D-uality/Robocup-Singapore-Open/Robocup Notebook.docx

Robocup Notebook

Robocup 2023 – Frederick Sun | Yuki Wu

# Design Process

## Composition of Robot

The composition of our robot is extremely important, as it determines how all the components fit together, what software we need to be able to program, and how different things are needed to sustain a closed-loop feedback system for a task as intensive as ours.

### Design Material

When building the robot, the basic material needs to be considered. We are aiming for a material that fits:

- Something strong and not brittle, can handle excessive forces.
- Can be easily modified so many different iterations can be tested.
- How readily available it is to our team, in New Zealand, and the relative cost of it.

The options are:

#### Nylon

Nylon is extremely lightweight and low in density, only just 1.14g/cm^3. This would be advantageous to use in higher quantities as it is extremely light and has no significant impact on the design structure of our robot.

Furthermore, Nylon has a great compressive force resistance, with its Young Modulus, E, at 2.7GPa. This would allow us to hold all the heavy components without issue and 3be able to support varying loads.

However, working with Nylon is hard and dangerous. Using Nylon would usually leave a trace of hard, sharp residue after cutting, which poses serious safety concerns.

#### Fibreglass Boards

Fibreglass is extremely strong with a Young Modulus of up to 87 GPa, significantly more resistant to damages that may occur, such as snapping or cracking when being handled. This is one of the main advantages.

It is relatively inexpensive, and easy to work with. However, the execution of creating small, precise hole cut outs is questionable. Furthermore, it requires the use of a binding material, through resin, which would only further complicate the matter.

Another concern is its density. At roughly 48g/cm^3, this is significantly heavier than that of the other materials, and would create extra strain on the motors, which is unneeded for.

#### PLA – 3D Printing

#### ABS – 3D Printing

### Wheels

The size of the wheels depends on the radius and the thickness. These two factors

### Microcontroller

### Claw Design

### Dump Design

Using linkage, we were able to simulate a 2d version of the entire robot and it's mechanisms

## Line Following

### Closed Loop system

The line following process is a complex one: involving many different techniques. We aim to use a closed-loop information feedback system to accurately control our robot and its position within the course. This will improve its accuracy and reliability.

Given the inputs v, for colour sensor inputs, and t, for time, we can use the PID controller to determine the accurate output as a function of both inputs, o(v, t).

This formula describes how the output given time and the sensor inputs can be determined.

e(v,t) is the error difference between two sides of the colour sensors rack, as an error of 0 would indicate that the colour sensors are reading the same value, therefore the same colour, which is most likely both white.

describes the sum of all errors since the controller has started to run. Gives indication to how long an error has been occurring with respect time, showing how this must be a longer turn. This would only work if the error would go negative, otherwise there would be a systematic error to turn whichever way was described as positive.

describes the rate of change of error, given the smallest change in t, which is the last reading. This would give indication as to how rapidly the error is changing with respect to time, meaning any given turn is sharper, hence needing more power.

To properly implement this into our system, we would need to use modified values, as the raw values are much too large to work with for motors. Through 3 different constants,

### Limitations

#### Integral

Using this method does come with limitations, as this is not applicable for our scenario. Given that the error may range between -400 to 400, suggesting that the integral would change dramatically. This means that there would be a high impact relatively, compared to the other parts of the system.

The common solution would have been to lower to KI value. We usually lower it to 10^-4, where there isn't any more impact on the turning to be noticeable. This comes with its drawbacks – the integral is not being properly utilized, and hence we lose out on a major component of the program.

Another issue is when there are multiple turns facing the same way. If the integral takes from 0 to t, current time, then all the past errors will be remembered, and hence if there are consecutive left or right turns, then there would be a bias to turn left or right as the integral value would be high.

This can be seen through an example,

Suppose we have these boards: all consecutively lined up (Although this wouldn't happen in a real scenario, filler boards can be added, achieving the same effect).

Imagine the error as we proceed through these boards, the therefore the sum of errors as integral (Taking a left error as positive, right error as negative)

You can see that after all these turns, there's a clear positive integral. Assuming that the size of errors is consistent for both left and right turns, then we would have been left with a large, positive integral after these turns. Now imagine if the next turn was as follows:

We have a bias to turn left because of the previous turns, and therefore when trying to turn to the right, the proportional and derivative components will have their impacts reduced as the integral still believes that it is trying to turn to the left.

This may lead to the robot missing/underperforming when trying to turn in the opposite direction without buildup. These situations are highly likely, seeing how large the errors can get to, and depending on the curve/sharpness of the turn, how much is stored inside the integral function.

However, we can take advantage of this, instead of simply removing its large impact on the controller. If we can identify the start and end of a turn, then we can apply the integral to said timestamps:

This means that we can properly take the integral of any turn, and given how long the error lasts, adjust for a higher and sharper turn.

#### Derivative

The derivative measures the rate of change of error. This can be achieved through measuring the last error, and current error, giving the cheapest equation possible to solve for gradient. This is because e(v, t) does not follow a standard formula, to give predictable results, as it relies on the error function which varies a lot with time.

Furthermore, the baud rate of the Arduino in our program is at 115200 bits per second, and the average program cycle is around ___, which is quick. This results in small values of change between cycles and readings of error, hence the derivative function would have little impact, as it is many small changes over a longer period, compared to a big change over small period, leaving a sharp gradient to be calculated.

However, we can use an artificially delayed function, so instead of taking the derivation between the smallest possible unit of time (between two program cycles), we take an arbitrary one between two different program cycles some time apart.

This lowers the accuracy of the gradient for any given point, and therefore has bigger variations, which would help the robot follow the line as big changes are impactful and may tell us more about the line it's following.

For example:

This seems great on paper but does not account for the end of a turn, where the robot may overcompensate for how much to turn by. We can solve this through incorporating both methods of finding the gradient. Applying the second formula when the change in error spreads from 0, and the first formula when the error returns to 0.

## Intersection Handling

The line following is broken up and made more difficult through the inclusion of intersections, where green tiles are placed around an intersection of black lines, to determine where the robot should go.

Having the 6 sensors we have, this task would have been diminished in difficulty, as there would be more information points when the robot does cross over the intersection, to easily determine which case it is.

There are two approaches to handling intersections:

### Green -> Black

This method checks for green first, and then checks if it is an intersection by checking for black.

### Black -> Green

## Obstacle Detection

## Rescue Kit Detection

## Rescue Zone

# Robot Design Iterations

# Daily Entries

## 19th August 2023

Today, our team discussed with our mentor how our process is going. We have figured out that this isn't really working, with all the constant changes to the design, which is taxing and slowing down our efficiency in completing the task. For instance, we printed many different designs for the touch frame, for it to not be used and replaced with laser sensors: we had spent over 5 weeks of designing and printing them, for them to not be used in our current versions.

Our mentor had this comment: you must plan everything before you print, no matter what. Plan properly with the correct measurements and do it right, don't just make something and try it out. Do the proper research first, calculate the forces required to act on the joystick for it to register signals. Create a small setup for testing purposes only as well, don't just move it onto the main robot instantly, because that's a lot of planning for something as uncertain as trial and error.

I have decided that this issue stems from our past experiences. With LEGO EV3, there was little planning and precise measurements taken when building the robot. This is because the pieces were made to commercial grade standards, and could be easily assembled and disassembled, resulting in a "build now, test later, take apart if it doesn't work" approach.

This worked extremely well for LEGO specifically, as everything as easy to change, and when we encountered a problem, it could have easily been fixed without any thought because it'd just be replacing a small part, not the entire structure.

This mindset has continued to our Arduino journey, and therefore severely impacted our design flow. No longer can be simply design now, test it out, and redesign quickly, because the 3d models took hours to print. Furthermore, the use of screws, nuts, and custom wires, all handmade created a lot of extra strain on the assembly part. Additionally, the total control that we now have over every single measurement also restricted the speed at which we could operate, as now everything had to be considered.

So from now on all of our models are going to be fully measured out, with as many scenarios as possible considered, to minimise wasting time and effort in 3d printing, assembling, and finally disassembling.

## 24th August 2023

The initial approach to this would be through the scientific method, where there would be control, dependent, and independent variables to build the robot with.

We will be following this structure:

- Motor bracket size is constant. Separation dependent on size of battery holder Constant
- Limited base board size Dependent
  - Placements of the dump and lift motors are limited. Independent/Dependent
  - Available space remaining for the other components (Arduino, Voltage Regulator/Stepdown, Switch, Handle). Independent/Dependent
- Wheel Separation and Height is constant. Constant
  - Colour sensor height Dependent
  - PID Controller aggressiveness Dependent
  - Position of the colour sensors Dependent

Then we would follow the path of building an aim, hypothesis, collecting data, and then drawing conclusions from a table, graph.

## 9th September 2023

Completed Linkage simulations for the dump and modelling it into Tinkercad.

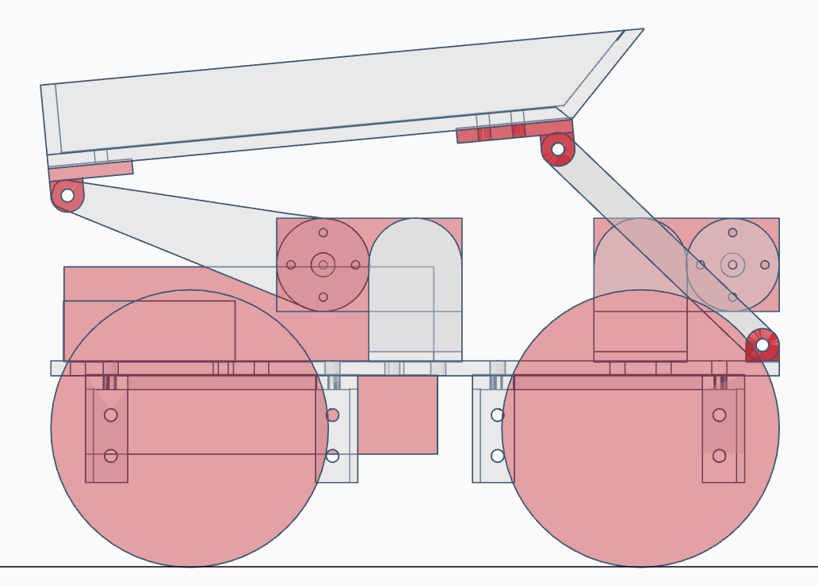
[picture p1: figure]
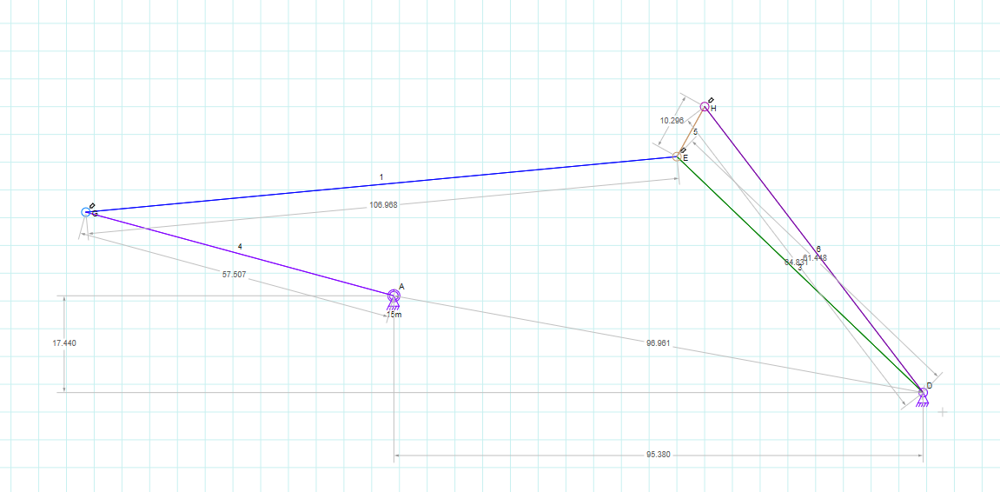
[picture p2: figure]

This would allow us to measure the approximate locations of other components.

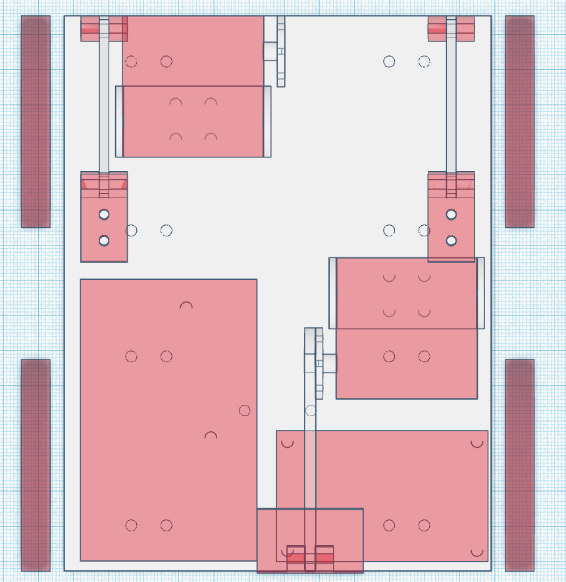
[picture p3: figure]

It shows what limited space we have if we wanted to be efficient and use all the space available to us. This would help benefit our size, and create a small compact robot that can easily traverse under bridges, and squeeze into the small tiles without falling off.

One concern is that the wheels are too close together, which may lead to the entirety of the robot tipping over when going over the seesaw.

The robot seems to be back heavy, however, the composition of the claw and the weight of the motors has not been accounted for.

Will continue development with redesigning the claw, seeing as it does not currently fulfil the demands of the evacuation zone completely – it is too large and clunky, and may have difficulty fishing balls out of corners where they may be stuck.
