D-uality/Robocup-Singapore-Open/Design/Base/Main Base.stl

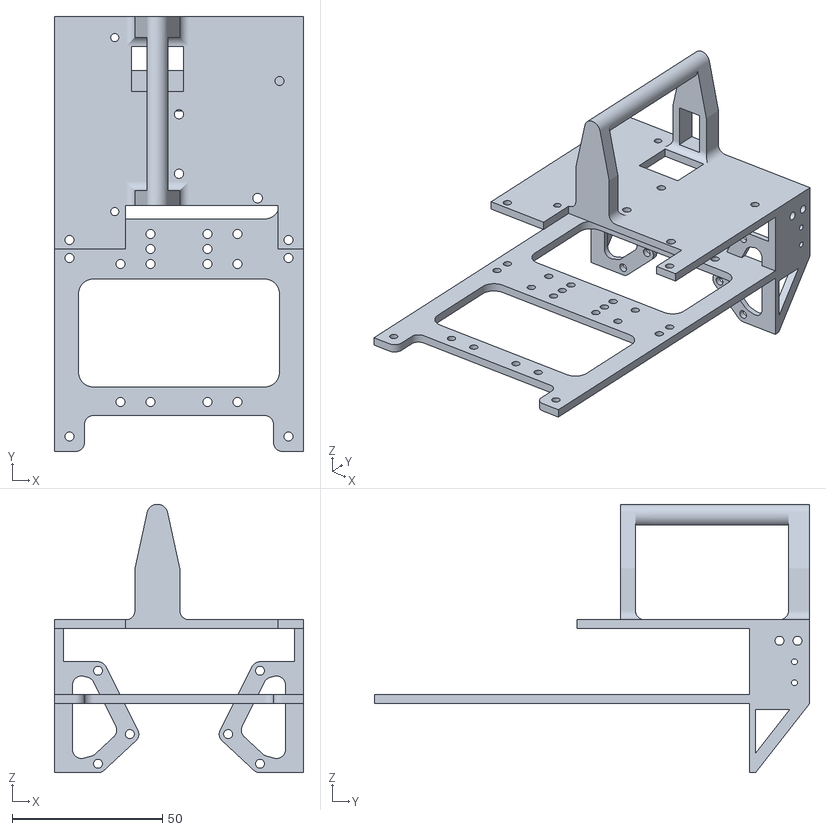
[picture p4: CAD file, 2024-03-02]
Design/Base/Main Base.stl
83.0 x 145.0 x 89.5
