D-uality/Robocup-Singapore-Open/Design/Attachments/Camera + Touch Frame.stl

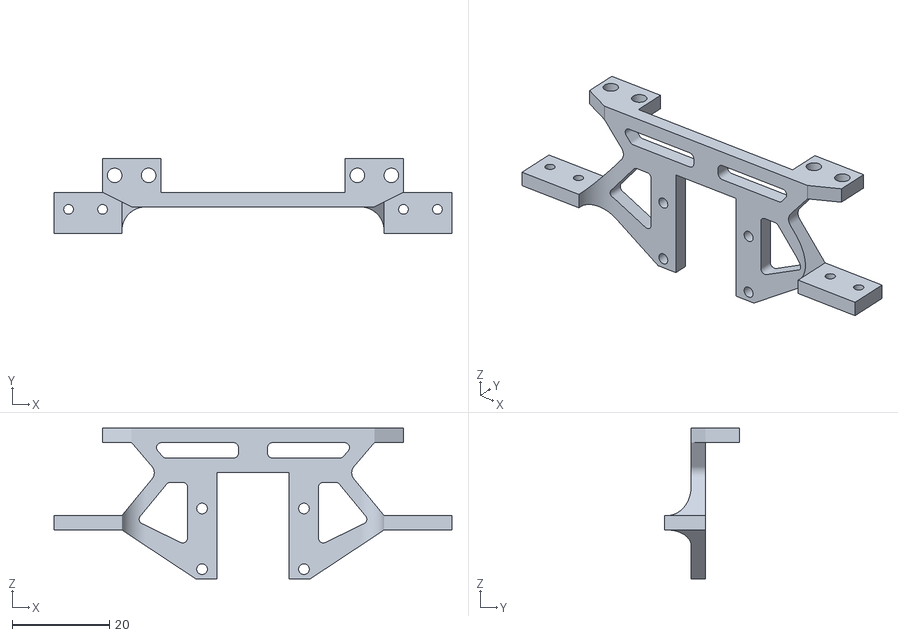
[picture p5: CAD file, 2024-03-01]
Design/Attachments/Camera + Touch Frame.stl
82.0 x 15.5 x 31.1
