D-uality/Robocup-Singapore-Open/Design/Base/Claw Base.stl

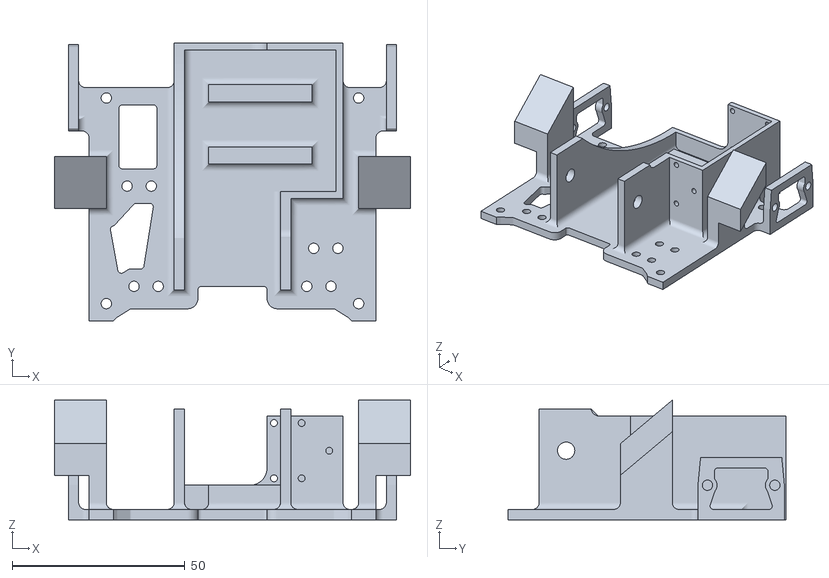
[picture p6: CAD file, 2024-03-10]
Design/Base/Claw Base.stl
103.0 x 80.4 x 34.6
