D-uality/Robocup-Singapore-Open/Design/Claw/Left/Left - Side Gear.stl

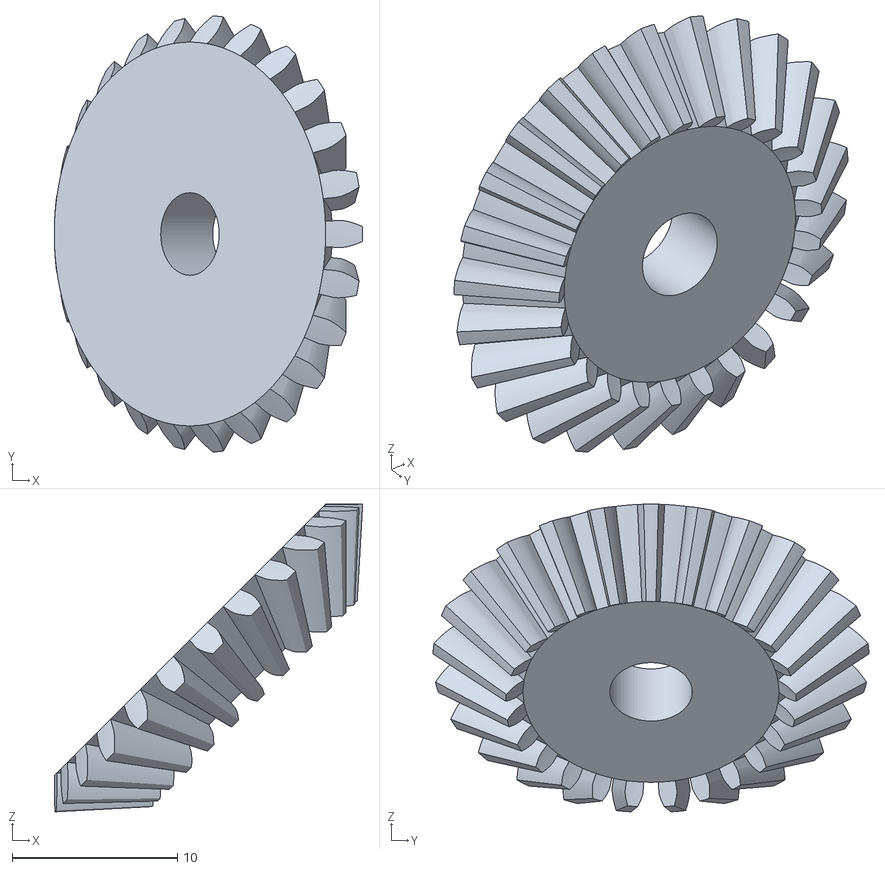
[picture p7: CAD file, 2024-03-30]
Design/Claw/Left/Left - Side Gear.stl
18.7 x 26.4 x 18.6
