D-uality/Robocup-Singapore-Open/Design/Claw/Rotating Frame Connector.stl

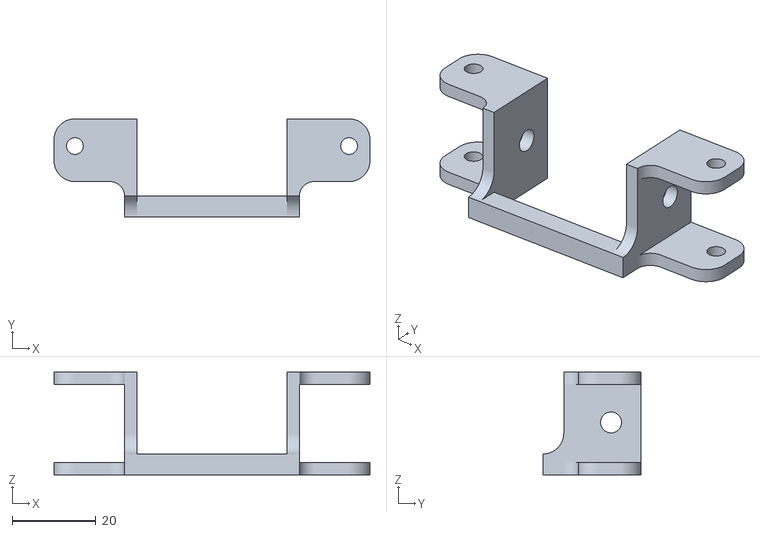
[picture p8: CAD file, 2024-03-10]
Design/Claw/Rotating Frame Connector.stl
75.5 x 23.5 x 24.6
