D-uality/Robocup-Singapore-Open/Design/Attachments/Angle IR Sensor Frame.stl

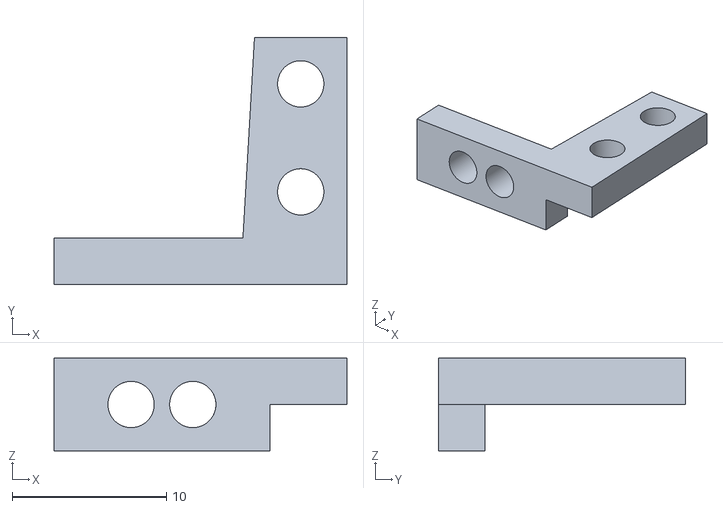
[picture p9: CAD file, 2024-03-01]
Design/Attachments/Angle IR Sensor Frame.stl
19.0 x 16.0 x 6.00
