D-uality/Robocup-Singapore-Open/Design/Claw/Left/Left - Small Gear.stl

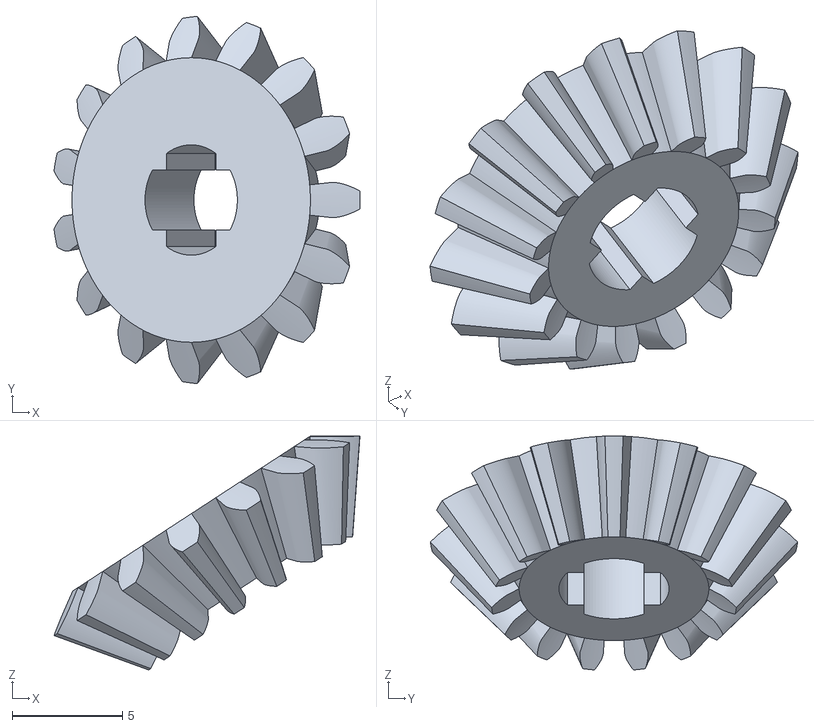
[picture p10: CAD file, 2024-03-30]
Design/Claw/Left/Left - Small Gear.stl
13.9 x 16.6 x 10.6
