D-uality/Robocup-Singapore-Open/Design/Claw/Right/Right - Claw.stl

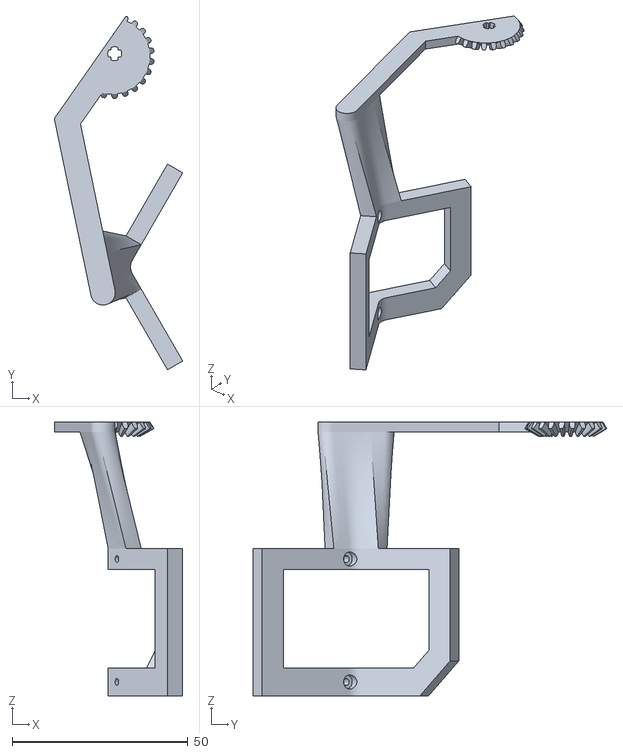
[picture p11: CAD file, 2024-03-30]
Design/Claw/Right/Right - Claw.stl
36.6 x 100.6 x 78.0
