D-uality/Robocup-Singapore-Open/Design/Base/Front Touch Bumper.stl

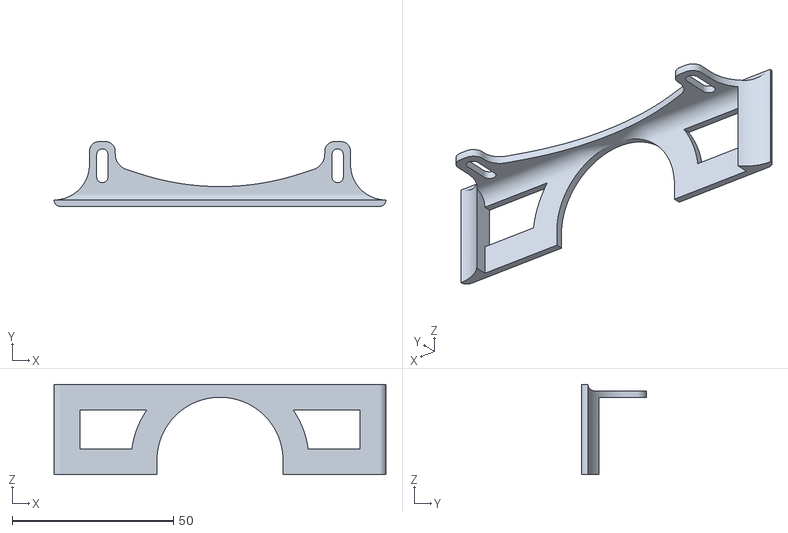
[picture p12: CAD file, 2024-03-01]
Design/Base/Front Touch Bumper.stl
103.0 x 20.1 x 28.0
