D-uality/Robocup-Singapore-Open/Design/Claw/Left/Left - Claw Support.stl

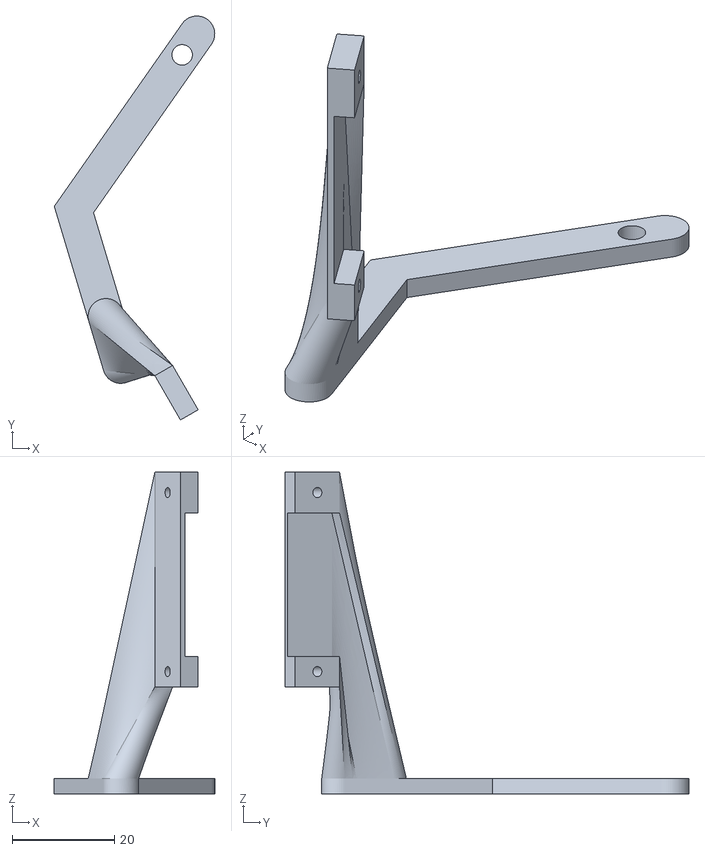
[picture p13: CAD file, 2024-03-30]
Design/Claw/Left/Left - Claw Support.stl
31.4 x 79.0 x 62.9
