D-uality/Robocup-Singapore-Open/Design/Base/Back Touch Bumper.stl

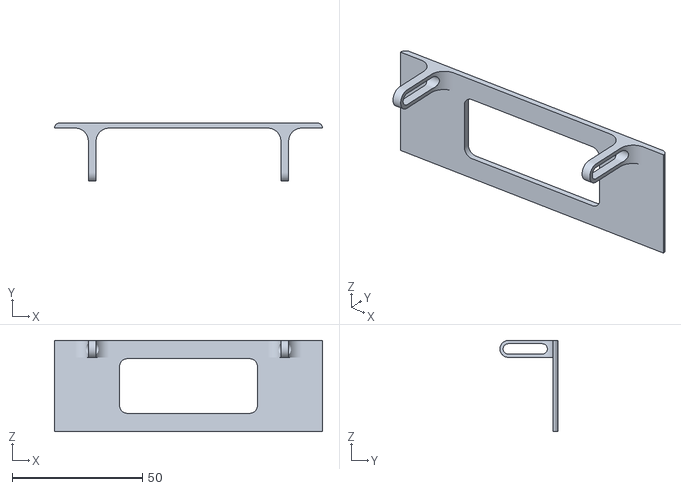
[picture p14: CAD file, 2024-03-01]
Design/Base/Back Touch Bumper.stl
103.0 x 22.4 x 35.0
