D-uality/Robocup-Singapore-Open/(list of files, cad)

Other CAD files:
Design/Claw/Right/Right - Side Gear.stl
Design/Attachments/Angle IR Sensor Frame(Mirror).stl
Design/Claw/Right/Right - Small Gear.stl
Design/Claw/Left/Left - Claw.stl
Design/Claw/Right/Right - Claw Support.stl
