D-uality/Robocup-Singapore-Open/(commit log)

2023-04-05 Changed code layout (1/3): - Changed from using PWM Driver to using Servo - Created class called Robot (cRobot) (Missing Run())
    [ModeSelector.h, Reading.cpp, Robocup.ino, Robot.cpp, Robot.h, Running.cpp, Testing.cpp]
2023-04-30 Changed Folder Layout (3/3): - Added Design folder to store 3d prints
    [Base.stl, Claw.stl, Gears.stl, Support.stl]
2023-05-13 Added more designs
    [Base.stl, Claw.stl, Gears.stl, Support.stl, Touch Frame.stl]
2023-05-15 Added Linkage files to design - Claw mechanism - [Future] Dump Container mechanism
2023-05-18 Changed Claw Design - Added double layers - Changed file names - Changed folder names
    [Base.stl, Claw.stl, Gears.stl, Support.stl]
2023-05-19 Modified designs - Changed claw base to be more suited for the top layer - Updated claw design - Updated support beams - Revamped Touch frame to take up less space, with calculations
    [Base.stl, Claw.stl, Support.stl, Touch Frame.stl]
2023-05-20 Changed Designs - Fixed some issues with Claw Base
    [Base.stl, Claw Lift Support.stl, Touch Frame.stl]
2023-05-20 Changed base and touch frame based off failure of last version - Too cramped for space at the top - Touch frame was bending
    [Base.stl, Touch Frame.stl]
2023-05-27 Changed the touch frame to have a smaller input - Minimizes rotational movement
    [Touch Frame.stl]
2023-05-27 Changes to design and code: - Started joystick control for obstacle detection - Baseplate redisign as components were clashing from the last one - Therefore the touch frame also had to be changed
    [Base.stl, Touch Frame.stl]
2023-06-02 New touch frame change! - Size profile made smaller Base change - With better soldering on the colour sensors, they will be able to be shifted forwards, creating less unusable space
    [Base.stl, Touch Frame.stl]
2023-06-03 Small modifications: - Base board had conflicting elements - Touch frame was too big
    [Base.stl, Touch Frame.stl]
2023-06-09 Changed microprocessor: - Arduino Mega replaced with Arduino Mega Pro Mini - Baseboard and Touch frame had to change as a result - Changed test code as a result Investigated more dump linkages - Crea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
    [Base.stl, Touch Frame.stl]
2023-06-23 Continued with touch development: - Added more code for functionality Changed Designs: - Bezeled edges and continuous pieces
    [Base.stl, Dump Base.stl, Touch Frame.stl]
2023-06-29 Made code consistent throughtout: - Serial monitor for debugging had had the strucutre changed - Now all sections begin without spaces, and end with spaces
    Claw Design:
    - Old claw was too big and bulky, so creating a different mechanism
    - Utilises a 3bar mechanism
    [Reading.cpp, Robocup.ino, Robot.cpp, Running.cpp, Testing.cpp]
2023-06-30 Claw Design modifications: - Modelled Linkage
    [Base.stl, Claw arms.stl, Claw.stl, Gears.stl, Support.stl]
2023-07-05 Touch Frame changes: - Too big for the slot, prevented backwards motion.
    [Touch Frame.stl]
2023-07-08 Design Changes - Made dump consistent - Added supporting beam that connects dump to servo
    [Dump Base.stl, Dump Support.stl]
2023-07-21 Design Changes: - First version with all components - Added Dump and Claw lifting mechanisms Code Changes: - Messed around with unsigned integers, as I could find that it overflowed when left running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
    [Claw Lift Support.stl, Dump Support.stl]
2023-07-28 NOTEBOOK ADDED!!??!?!?! - Keeps track of progress and reasoning, also goes into detail explaining how different things work - Updated Daily logs Dump Support shortened and mirrored: - Was bumping int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
    [Dump Support.stl]
2023-07-31 Dump support changed thinner: - Was making it harder to screw things onto it, made it smaller so that the screws do not clash too much
    [Dump Support.stl]
2023-08-02 Added a test holder for laser sensors: - Trying out laser sensor for long range detection in evac zone
    Updated Notebook:
    - Finished descibing limitations of integration from 0, start time, to t, current time
    [Laser Sensor Hold.stl]
2023-08-05 Baseboard updated: - Removed placement for joystick - Added holes for laser sensors
    [Base.stl]
2023-08-05 Added all attachments: - Motor Frame - Laser Sensor Hold
    [Laser Sensor Hold.stl, Motor Frame.stl]
2023-08-17 Added new attachments - Made the new attachments for the new base board
    [Laser Sensor Hold.stl, Motor to Dump.stl]
2023-11-03 Modules!
    Added a modules folder:
    - IR Sensor Module added.
    - Will help with calibration (custom heights)
    - Can detect analog values for different colours
    - More visable -> can be moved around more easily. Not attatched straight onto the robot.
    [IR Sensor Testing.stl, Motor to Dump.stl]
2023-11-23 Start of Raspberry Pi: - Changed base to include raspberry pi - Added servo approximation (degrees turned) - Removed touch frame seeing as we are no longer using it.
    [Base.stl, Touch Frame.stl]
2023-11-24 Changed design: - Added a second layer to house the electronics - + provides extra space - - increases height
    - Fitted RPI Camera onto the robot
    - Added servo precision turning
    [Base Layer 2.stl, Motor Positioning.stl, Pi Camera.stl]
2023-11-30 Fixed Designs
    [Base Layer 2.stl, Pi Camera.stl]
2023-12-27 Updated Designs
    [Base Layer 2.stl, Pi Camera.stl]
2024-01-07 Switched from TinkerCAD to Fusion 360, ergo updated models
    [Base Layer 2 Front.stl, Base.stl, Bevel Connection to Spur.stl, Claw arms.stl, Claw.stl, Gears.stl, Left Spur Gear.stl, Pi Camera.stl]
2024-01-12 First Design, with everything implemented for evac zone
    [Base Layer 2 Front.stl, Base Layer 2.stl, Bevel Connection to Spur.stl, Claw Base.stl, Claw.stl, Electronics Base.stl, Frame.stl, Left Claw.stl]
2024-01-18 Changed Claw Design
    [Big Bevel.stl, Claw Holder.stl, Connection Bevel.stl, Frame.stl, Left Claw.stl, Left Spur Gear.stl, Right Claw.stl, Right Spur Gear.stl]
2024-01-23 Reduced Height of robot
    [Base.stl, Battery.stl, Big Bevel.stl, Big Gear(Mirror).stl, Big Gear.stl, Claw Base.stl, Claw Holder.stl, Claw.stl]
2024-01-25 updated designs - incosistencies
    [Battery.stl, Rotating Frame.stl]
2024-02-06 FINAL DESIGN???
    - Added all the components
    - Claw works as intended
    - Added 4 laser sensors
    - More compact
    - Added easily removable battery
    [Base.stl, Battery Base.stl, Battery.stl, Big Gear(Mirror).stl, Big Gear.stl, Camera Frame.stl, Claw Base.stl, Claw Holder.stl]
2024-02-10 Changed Claw design to being more robust
    [Big Gear(Mirror).stl, Claw Base.stl, Claw Support Pusher.stl, Claw Support.stl, Claw.stl, Rotating Frame.stl]
2024-02-20 Design Changes:
    - Moved camera to bottom
    - Added room for touch sensors, replacing laser sensors
    [Angle IR Frame v4.stl, Battery Base.stl, Camera + Touch Frame.stl, Claw Base.stl, Claw Holder.stl, Claw Support Pusher.stl, Claw Support(Mirror).stl, Claw Support.stl]
2024-02-20 Forgot these files D:
    [Angle IR Module v7.stl, Angle IR Sensor Frame(Mirror).stl, Claw Pusher thingy.stl]
2024-03-01 Final version PLEASE
    [Angle IR Frame v4.stl, Angle IR Module v7.stl, Angle IR Sensor Frame(Mirror).stl, Angle IR Sensor Frame.stl, Back Touch Bumper.stl, Battery Base.stl, Big Gear(Mirror).stl, Camera + Touch Frame.stl]
2024-03-02 Combined some more stuff ):
    [Claw Base.stl, Main Base.stl, Rotating Frame Connector.stl]
2024-03-06 Updated models as there were problems
    [Claw Base.stl, Rotating Frame Connector.stl]
2024-03-10 Claw was getting stuck on rotating frame Tolarnces increased
    [Claw Base.stl, Left - Claw Support.stl, Left - Claw.stl, Left - Side Gear.stl, Left - Small Gear.stl, Left- Support Gear.stl, Right - Claw Support.stl, Right - Claw.stl]
2024-03-16 EVERYTHING IS COMING TOGETHERRRRRRRRRRRRRRRRRRRRRRRRR!!!!
    [Left - Claw Support.stl, Right - Claw Support.stl]
2024-03-17 Some sort of error with the old code, with remote IO over I2C, not sure why, so rebuilding rn
    [EvacZone.ino, EvaczoneWithRPI.ino]
2024-03-30 Failed attempt with the ai model, will be switching to canny detection But serial now works :shrug:
    [Claw Support Connector.stl, Left - Claw Support.stl, Left - Claw.stl, Left - Side Gear.stl, Left - Small Gear.stl, Left- Support Gear.stl, Right - Claw.stl, Right - Side Gear.stl]
